jagnamis/fuzz-face/pictures/inside of pedal.jpg

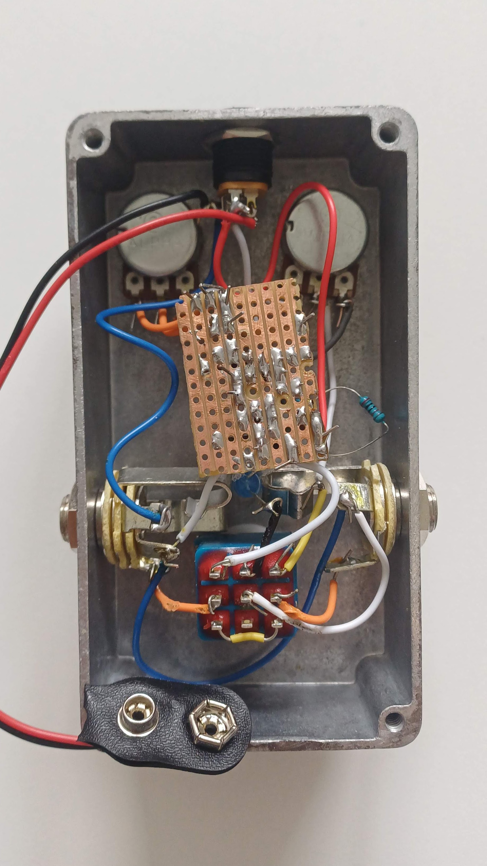
pictures/inside of pedal.jpg
