jagnamis/fuzz-face/README.md

## About

This project describes the process of creating a Fuzz Face guitar pedal from scratch. 

It uses Silicon NPN transistors, as opposed to the original's Germanium PNP. The circuit is also slightly modified from the original, aiming to eliminate high-frequency oscillations and boost the volume a little.

All files, except for the potentiometer library, were created by me.

Fuzz Face is a very simple circuit, so I soldered it on a Stripboard - for future, more complicated pedals I also aim to make PCBs.

### Schematic
Simplified schematic of the circuit, without off-board wiring:

Fuzz Face Schematic

Note the swapped 1 and 3 on the potentiometers. That's done so on the finished pedal the knob values will increase when turning clockwise.

### SPICE Simulation
The NPN transistor's gain is so high that even at a low input signal value like 40mV pp, 
the output signal goes into clipping:

SPICE Simulation at 40mV pp

As input signal's voltage increases (200mV pp), the duty cycle changes:

SPICE Simulation at 200mV pp

Pedal's frequency response:

SPICE Simulation of frequency response

At maximum fuzz (fuzz=1.0) we get a resonant frequency around 220Hz, so it'd best
not to turn the fuzz knob all the way when playing.

### Components needed

| Designator | Component | Notes |
|---|---|---|
| | Stripboard | |
| | Jumpers and wires | |
| | DC Barrel Jack | |
| | 3PDT | |
| | Battery clip | Can swap for 9V power supply |
| +9V | 9V Battery | |
| IN | Stereo Jack | |
| OUT | Mono Jack | |
| RV1 | Alpha B1K | |
| RV2 | Alpha A500K | |
| C1 | 2.2uF | Electrolytic |
| C2 | 10uF | Electrolytic, changed from 22uF|
| C3 | 0.01uF | Ceramic/Film |
| C4,C5 | 100p | Optional |
| R1 | 470 | changed from 330 |
| R2 | 47K | changed from 33K |
| R3 | 47K | changed from 100K |
| R4 | 6.8K | changed from 8.2K |
| Q1,Q2 | BC548C | High gain of ~500 |
| R5 | 20K | Optional |
| D1 | LED | Optional |

Most of the component swaps (C1, C2 electrolytic instead of film; R2, R3, R4 values) are simply because that's what I had, and the differences are minor. 

The changed C2 value and additional C4 & C5 capacitors aim to eliminate high-frequency oscillations and noise. 
Swapping R1 from 470 to 330 was done to boost the output volume.

### Breadboard

Before soldering on a Stripboard, I've tested the circuit on a breadboard.

I won't bother describing it here, as some great instructions already exist. A very good step-by-step write-up can be found here: [Breadboarding A Silicon Fuzz Face](https://diy.smallbearelec.com/HowTos/BreadboardSiFF/BreadboardSiFF.htm).

### Off-board wiring

Off-board wiring schematic was done in DIY Layout Creator:

Offboard wiring

The wiring with a 3PDT allows for True Bypass, meaning the pedal won't influence the signal when the pedal is off.

3-pin DC jack means that when using both a battery and a Power Supply, the battery is not supplying power.
Stereo Input Jack wiring also allows to not drain the battery when the pedal is not in use.

The finished pedal's insides:

Inside of pedal

I'll admit the soldering is not the prettiest job. Something to improve on!

When purchasing the enclosure, for simplicity, I ordered a pre-drilled enclosure. 

The pre-drilled layout however doesn't allow for a 9V battery to fit inside the pedal.

In order to avoid something like this it'd be best to drill the enclosure yourself - or ditch the 9V battery altogether, using only a 9V power supply. 

Important to note that as most pedals do, this one uses a center negative barrel jack, and there's no reverse voltage protection, so be mindful of that.

### Comparison

SPICE Simulation vs Oscilloscope:

oscilloscope_comparison

I think it's fair to say the signals are quite similar. The differences will mostly boil down to component tolerances (For example, the 500K pot used here
actually measures ~440K Ohms).

### Pedal Demo

to be done

### Acknowledgments

Some very useful links:

* [Geofex's The Technology of the Fuzz Face](http://geofex.com/article_folders/fuzzface/fftech.htm)
* [Barbarach's Pots for SPICE](https://barbarach.com/pots-for-spice/)
* [Madbeanpedal's off-board wiring write-up](https://madbeanpedals.com/tutorials/downloads/MBP_FootswitchWiring.pdf)
