jagnamis/fuzz-face/pictures/frequency_response.png

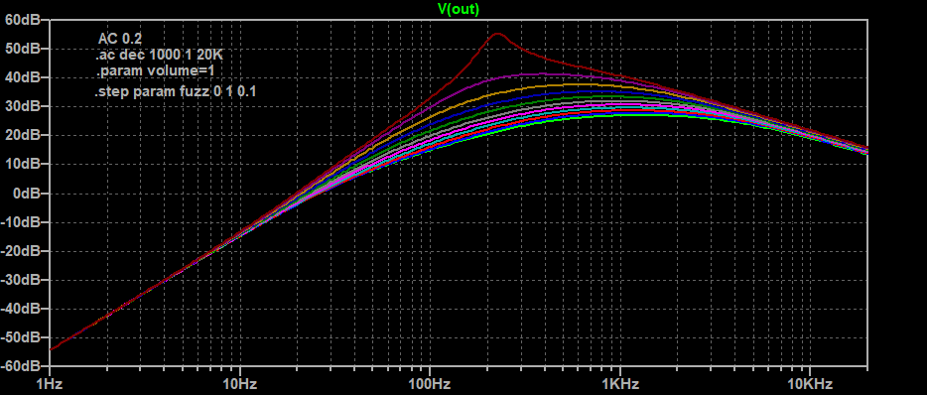
pictures/frequency_response.png
