jagnamis/fuzz-face/pictures/oscilloscope_100mV.png

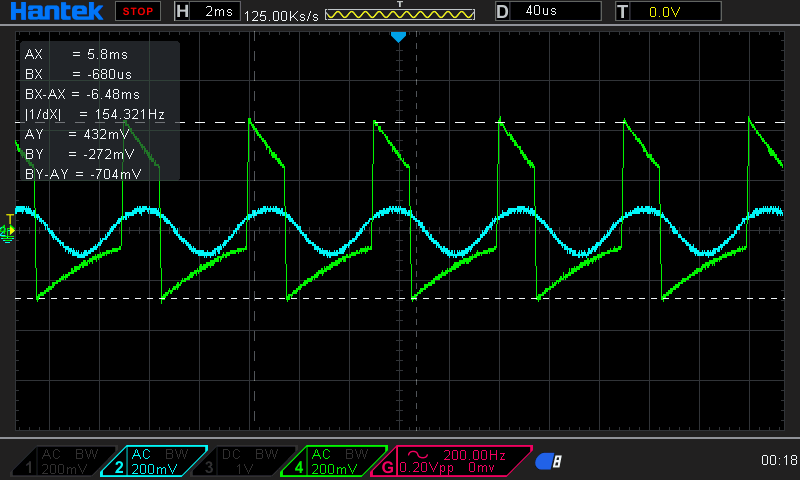
pictures/oscilloscope_100mV.png
