jagnamis/fuzz-face/pictures/oscilloscope_100mV_spice.png

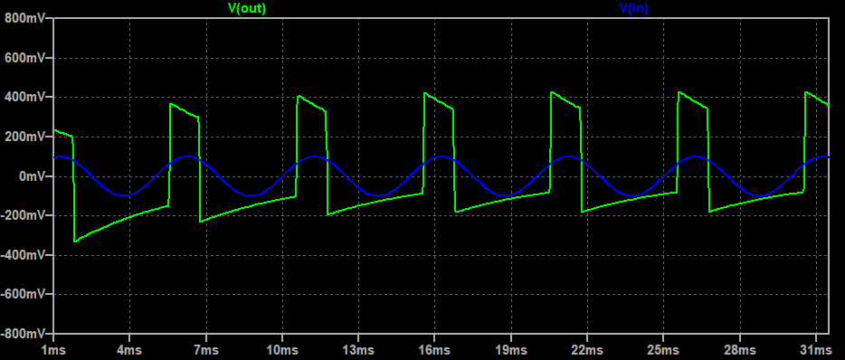
pictures/oscilloscope_100mV_spice.png
