jagnamis/fuzz-face/pictures/oscilloscope_comparison.png

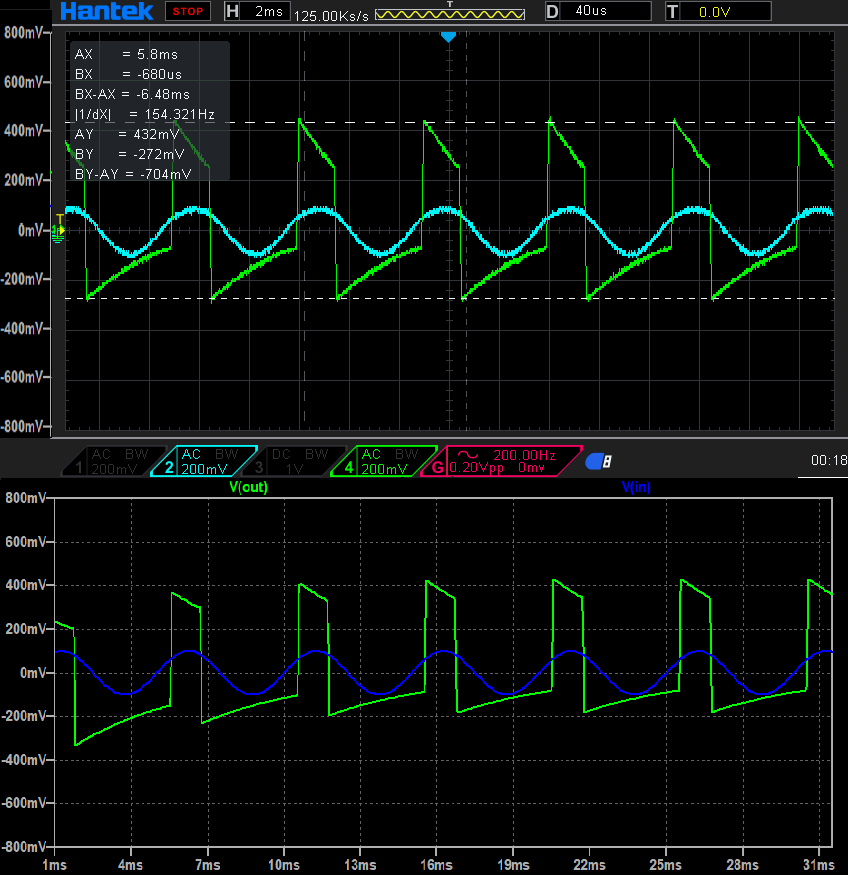
pictures/oscilloscope_comparison.png
