jagnamis/fuzz-face/pictures/Schematic.png

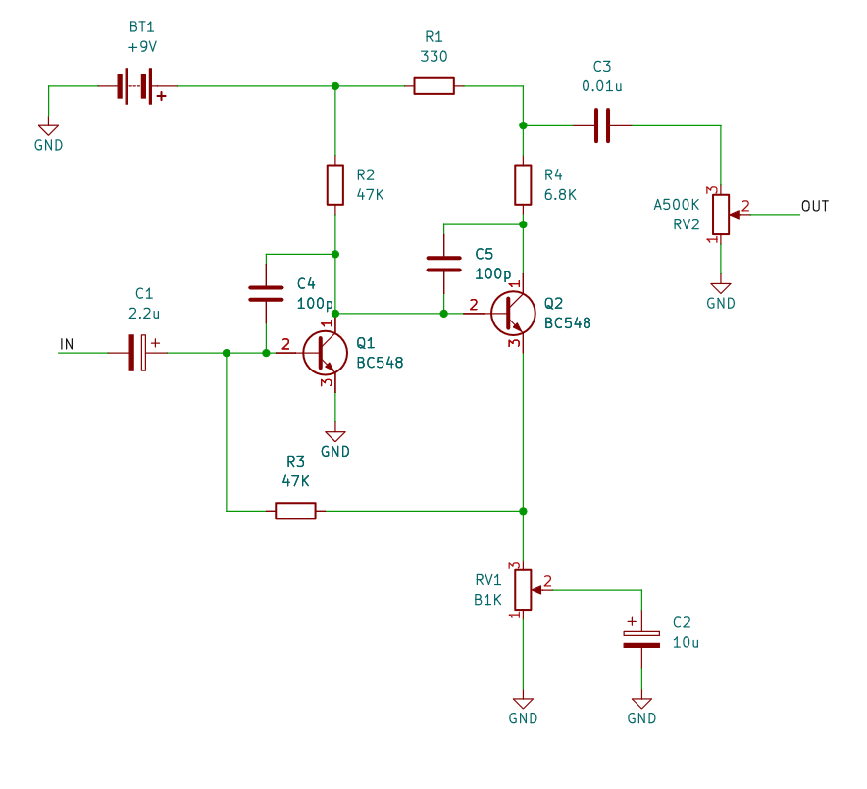
pictures/Schematic.png
