jagnamis/fuzz-face/pictures/transient_10mV.png

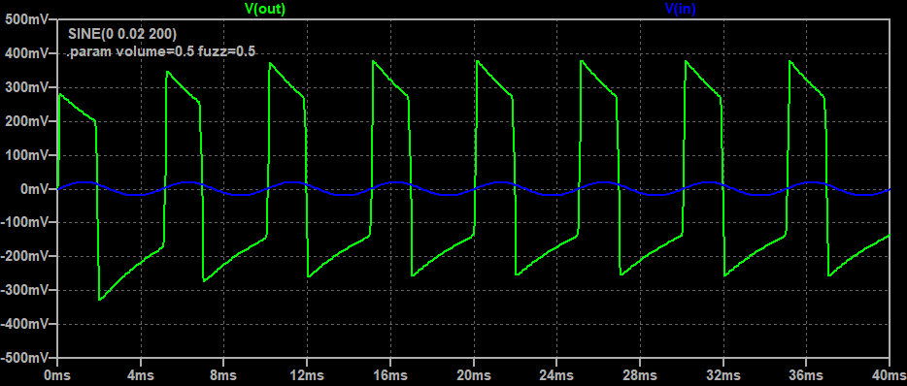
pictures/transient_10mV.png
