jagnamis/fuzz-face/pictures/transient_100mV.png

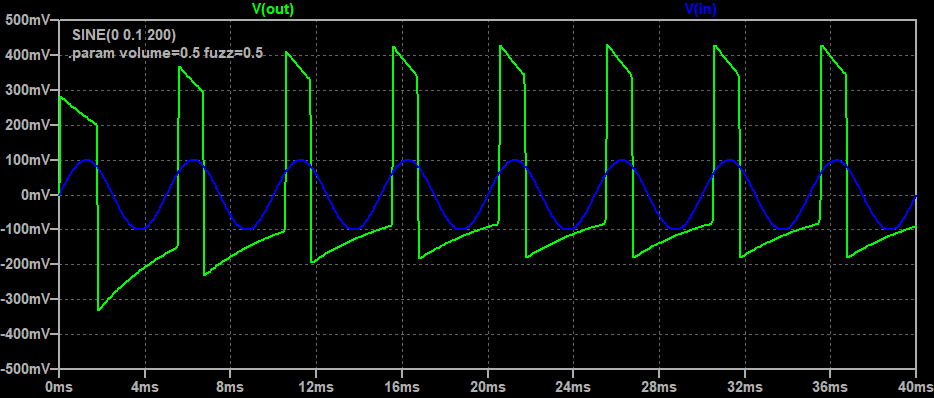
pictures/transient_100mV.png
