jagnamis/fuzz-face/SPICE/FuzzFace.asc

C1: polcap; 2.2µ
C2: polcap; 10µ
C3: cap; 0.01µ
C4: cap; 100p
C5: cap; 100p
Q1: npn; BC548C
Q2: npn; BC548C
R1: res; 6.8K
R2: res; 47K
R3: res; 470
R4: res; 47K
RV1: pot; Rt=1K set={fuzz}; ""
RV2: pot; Rt=500K set={volume}; ""
V_Bat: voltage; 9V
V_In: voltage; SINE(0 0.1 200); AC 0.2
Named nets: 0, IN, +9V, OUT
.tran 28m
.param volume=1 fuzz=1
;.step param volume 0 1 0.2
;.step param fuzz 0 1 0.5
.ac dec 1000 1 20K
