jagnamis/fuzz-face/pictures/Offboard wiring.png

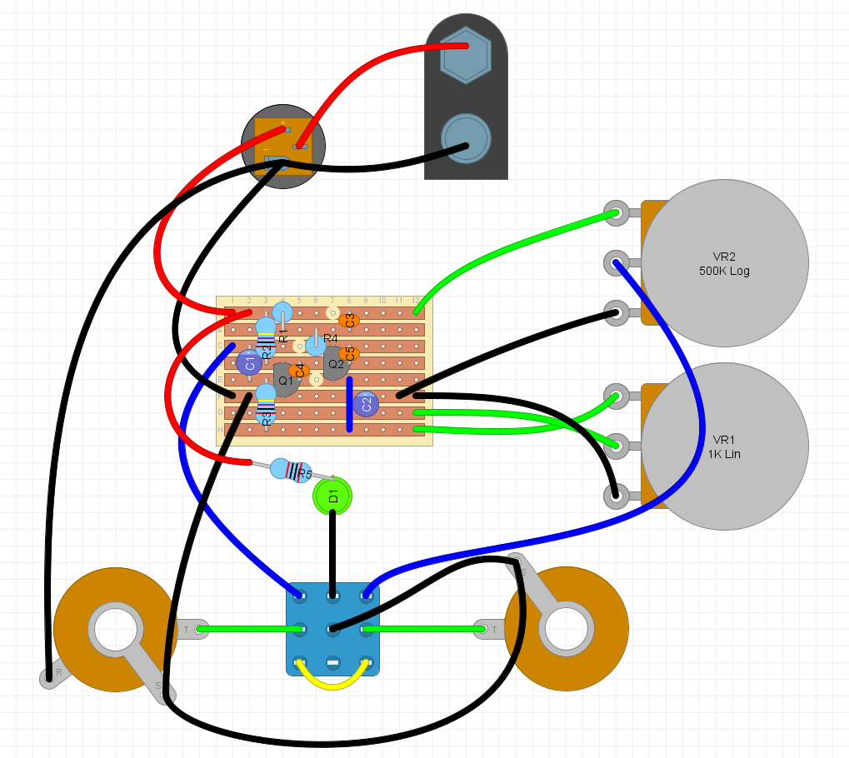
pictures/Offboard wiring.png
